1bigpig/NE_RotaryTable/NE_i2c_Connection.png

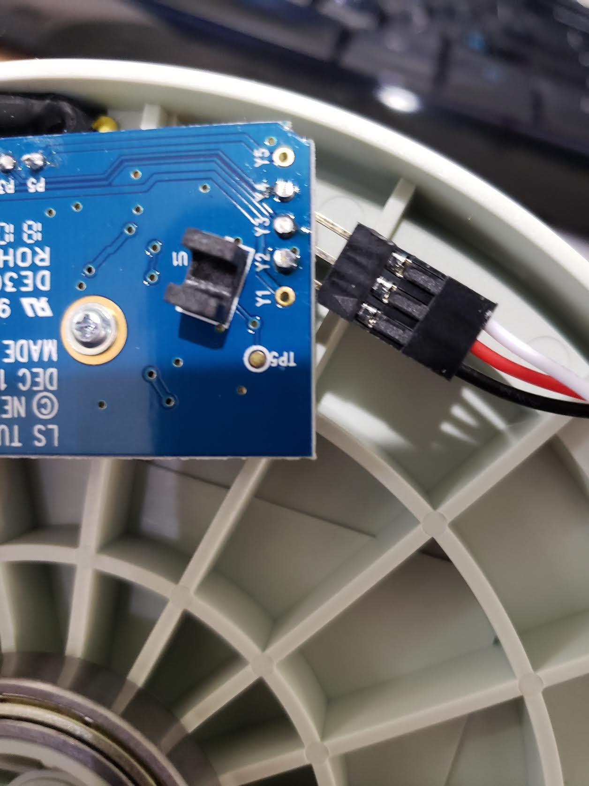
NE_i2c_Connection.png
