1bigpig/NE_RotaryTable/(commit log)

2021-02-01 Create NE_RotaryTable.c
    Arduino Uno with 28BYJ-48 stepper motor/ULN2003 driver to emulate a NextEngine rotary table.
2021-02-01 Add files via upload
    Arduino .ino project file.
2021-02-09 Latest update
    Decoded more of the command/response structure.
    Added an "activity" light to show when I2C data is being communicated
2021-02-09 Add files via upload
    Fixed error in Index mark math.
    Changed location in code of where calculation is performed.
    [NextEngine_MyTurntable_limited_Response.ino]
2021-02-15 Add files via upload
    Uses a single float calculation for better stepper conversion. Also added full responses for 0x81 (location) command.
